TahaAmjad/Soft-Robotic-Fish/Control board expense w-o valves.xlsx

Control Board w/o valves and taxes
No. | ITEM | PRICE | Taha | Usman | Descrption | Vendor
1 | Arcyclic | Rs 260.00 | Rs 130.00 | Rs 130.00 | 3mm for panels 130rs/sqrft | Rafique Plastic
2 | Arcyclic | Rs 460.00 | Rs 230.00 | Rs 230.00 | 5mm for base 230 rs/sqrft | Rafique Plastic
3 | Screws and nuts | Rs 180.00 | Rs 90.00 | Rs 90.00 |  | Pak traders
4 | Sand papers | Rs 60.00 | Rs 30.00 | Rs 30.00 | 320,150 grit (smoothing sharp corners) | Dulux Paint Shop
5 | Wires | Rs 180.00 | Rs 90.00 | Rs 90.00 | Different size wires | hallroad
6 | Extensions | Rs 500.00 | Rs 250.00 | Rs 250.00 | Lifting Panels from base frame | Brandreth Road | *
7 | Thimbels | Rs 140.00 | Rs 70.00 | Rs 70.00 | connector for asthetic look | hallroad | *
8 | Power Switch + Light | Rs 500.00 | Rs 250.00 | Rs 250.00 | heavy duty power switch and light | imported | *
9 | Banana Connectors | Rs 60.00 | Rs 30.00 | Rs 30.00 | for connection with supply | hallroad.org | *
10 | Buck Regulator | Rs 300.00 | Rs 150.00 | Rs 150.00 | stepping down 24vdc to 5vdc | IC SHOP | *
11 | Relay Module | Rs 600.00 | Rs 300.00 | Rs 300.00 | controlling solenoid valves | IC SHOP | *
12 | Rocker Switch | Rs 40.00 | Rs 20.00 | Rs 20.00 | main power | hallroad.org | *
13 | Fuse Holder | Rs 40.00 | Rs 20.00 | Rs 20.00 | circuit protection | hallroad.org | *
14 | IEC Power Connector | Rs 100.00 | Rs 50.00 | Rs 50.00 | main power connector | hallroad | *
15 | terminal Blocks | Rs 100.00 | Rs 50.00 | Rs 50.00 | connecting wires | hallroad.org | *
16 | Arduino Mega | Rs 1200.00 | Rs 600.00 | Rs 600.00 | microcontroller | hallroad | *
17 | Arduino Wires | Rs 150.00 | Rs 75.00 | Rs 75.00 | arduino wires | hallroad | *
18 | Toggle Switches | Rs 80.00 | Rs 40.00 | Rs 40.00 | manual valve control | hallroad.org | *
19 | POTs | Rs 100.00 | Rs 50.00 | Rs 50.00 | varying switching for indiv. Valve | hallroad | *
20 | Fuse | Rs 30.00 | Rs 15.00 | Rs 15.00 | circuit protection | hallroad | *
21 | Panel Sockets | Rs 160.00 | Rs 80.00 | Rs 80.00 | bulk head unions 40Rs | IPH
22 | 6m5 male connectors | Rs 600.00 | Rs 300.00 | Rs 300.00 | connectors pipe with valve base 25Rs | IPH
23 | 6mm - 4mm convertors | Rs 80.00 | Rs 40.00 | Rs 40.00 | pipe size convertor 20Rs/ft | IPH
24 | 6mm pipe | Rs 820.00 | Rs 410.00 | Rs 410.00 | 6mm pnematic pipe 18Rs/ft | IPH
25 | 4mm pipe | Rs 105.00 | Rs 52.50 | Rs 52.50 | 4mm pnematic pipe 7Rs/ft | IPH
 | Total | Rs 6845.00 | Rs 3422.50 | Rs 3422.50
 | Due per Group | Rs 3422.50
 | Balance |  | Rs 0.00 | Rs 0.00
 | Total (Groups) | Rs 6845.00
