TahaAmjad/Soft-Robotic-Fish/Soft Robot.xlsx

SOFT ROBOT w/o taxes
No. | ITEM | PRICE | Taha | Usman | Tajammal | Descrption | Vendor
1 | 3D printing mold | Rs 5800.00 | Rs 5800.00 | Rs 0.00 | Rs 0.00 | PLA material 40rs per gram | 3D printing arena
2 | Arcyclic | Rs 160.00 | Rs 160.00 | Rs 0.00 | Rs 0.00 | center part mold 3mm 130rs per sqft | bedan road
3 | Screws and nuts | Rs 60.00 | Rs 60.00 | Rs 0.00 | Rs 0.00 | closing mold | Rashid hardware
4 | Silicon Caulk | Rs 840.00 | Rs 840.00 | Rs 0.00 | Rs 0.00 | Silicone Sealant 210 per bottle | Rashid hardware
5 | Silicon Gun | Rs 220.00 | Rs 220.00 | Rs 0.00 | Rs 0.00 | Gun for smmoth extrusion of silicon sealant | Rashid hardware
6 | Thinner | Rs 120.00 | Rs 120.00 | Rs 0.00 | Rs 0.00 | Walayiti Thinner (lower viscousity) | National Paint shop
7 | Miscelanoues | Rs 100.00 | Rs 100.00 | Rs 0.00 | Rs 0.00 | Wood,Boxes,Elfy,dish soap,petrol,drill bits | Local
 | Total | Rs 7300.00 | Rs 7300.00 | Rs 0.00 | Rs 0.00
 | Due per members | Rs 2433.33
 | Balance |  | Rs 4866.67 | -Rs 2433.33 | -Rs 2433.33
 | Total (members) | Rs 7300.00
